wl-base/winterlab/hardware/photos/hand-soldered.JPG

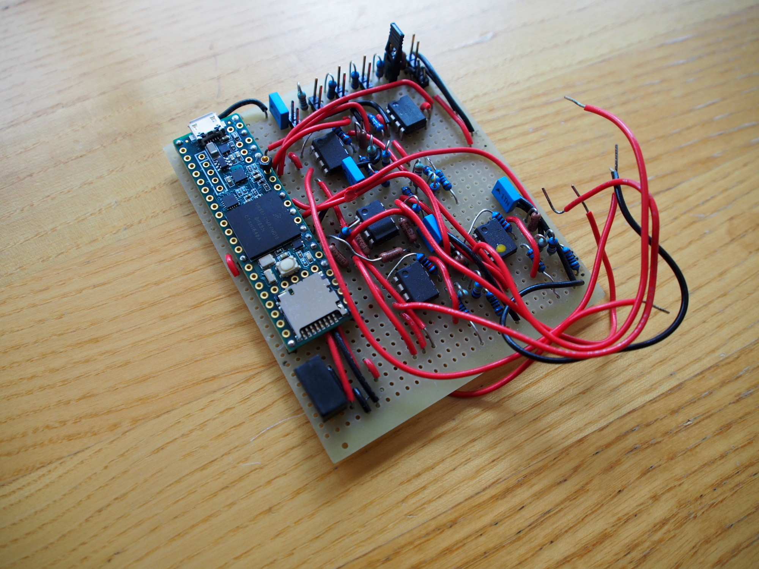
hardware/photos/hand-soldered.JPG
