wl-base/winterlab/hardware/schematics/winterlab_functional_diagram (7).png

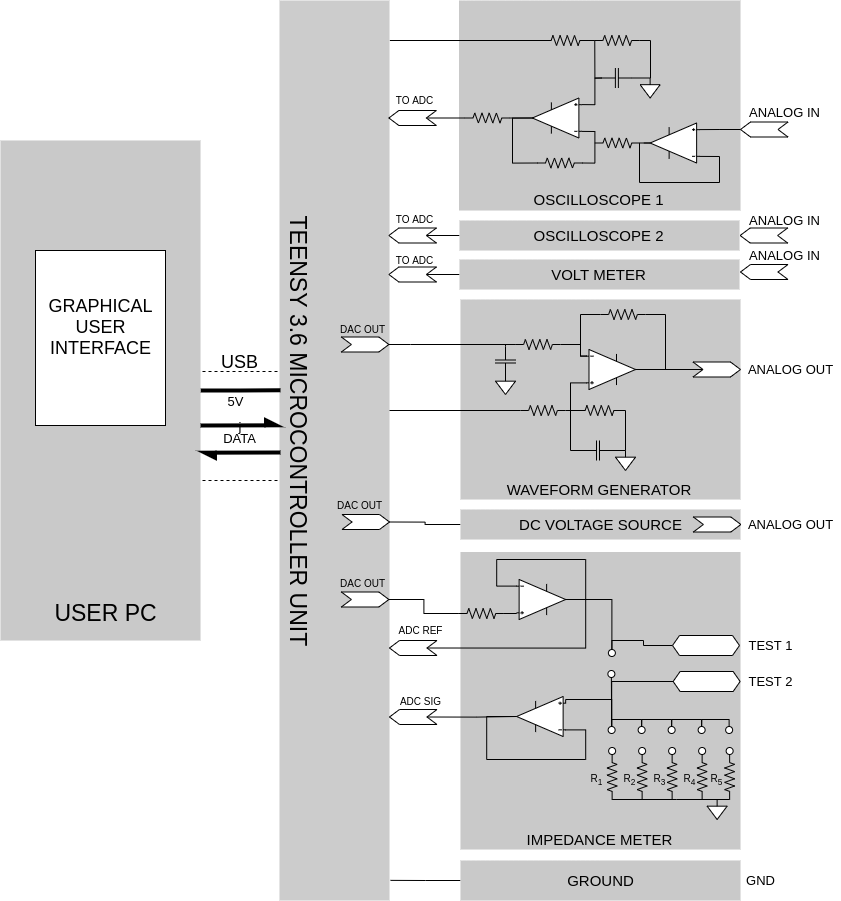
hardware/schematics/winterlab_functional_diagram (7).png
