wl-base/winterlab/hardware/photos/assembled_winterlab.pdf

### Example manufactured

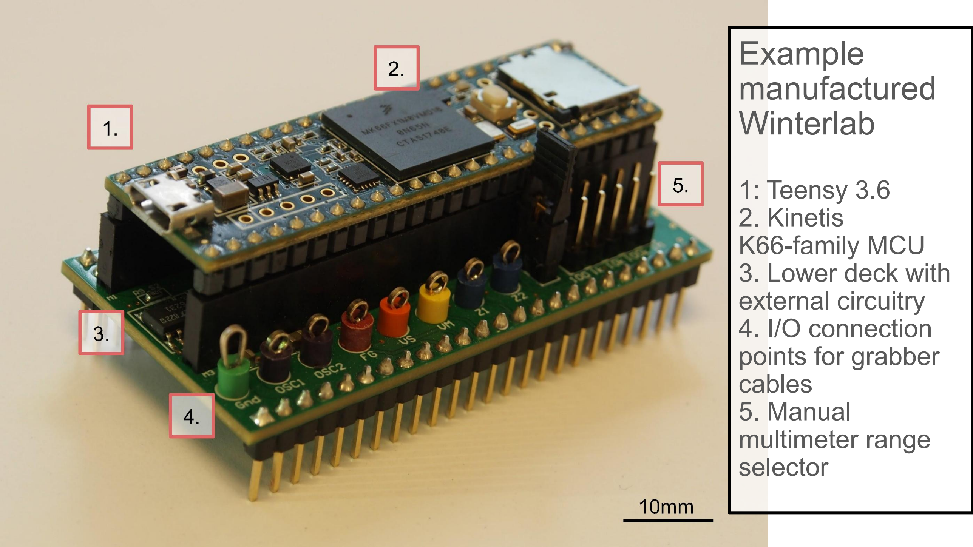
[picture p15: page 1]

### Winterlab

1: Teensy 3.6
2. Kinetis
K66-family MCU
3. Lower deck with
external circuitry
4. I/O connection
points for grabber
cables
5. Manual
multimeter range
selector
