wl-base/winterlab/hardware/schematics/WinterLab.pdf

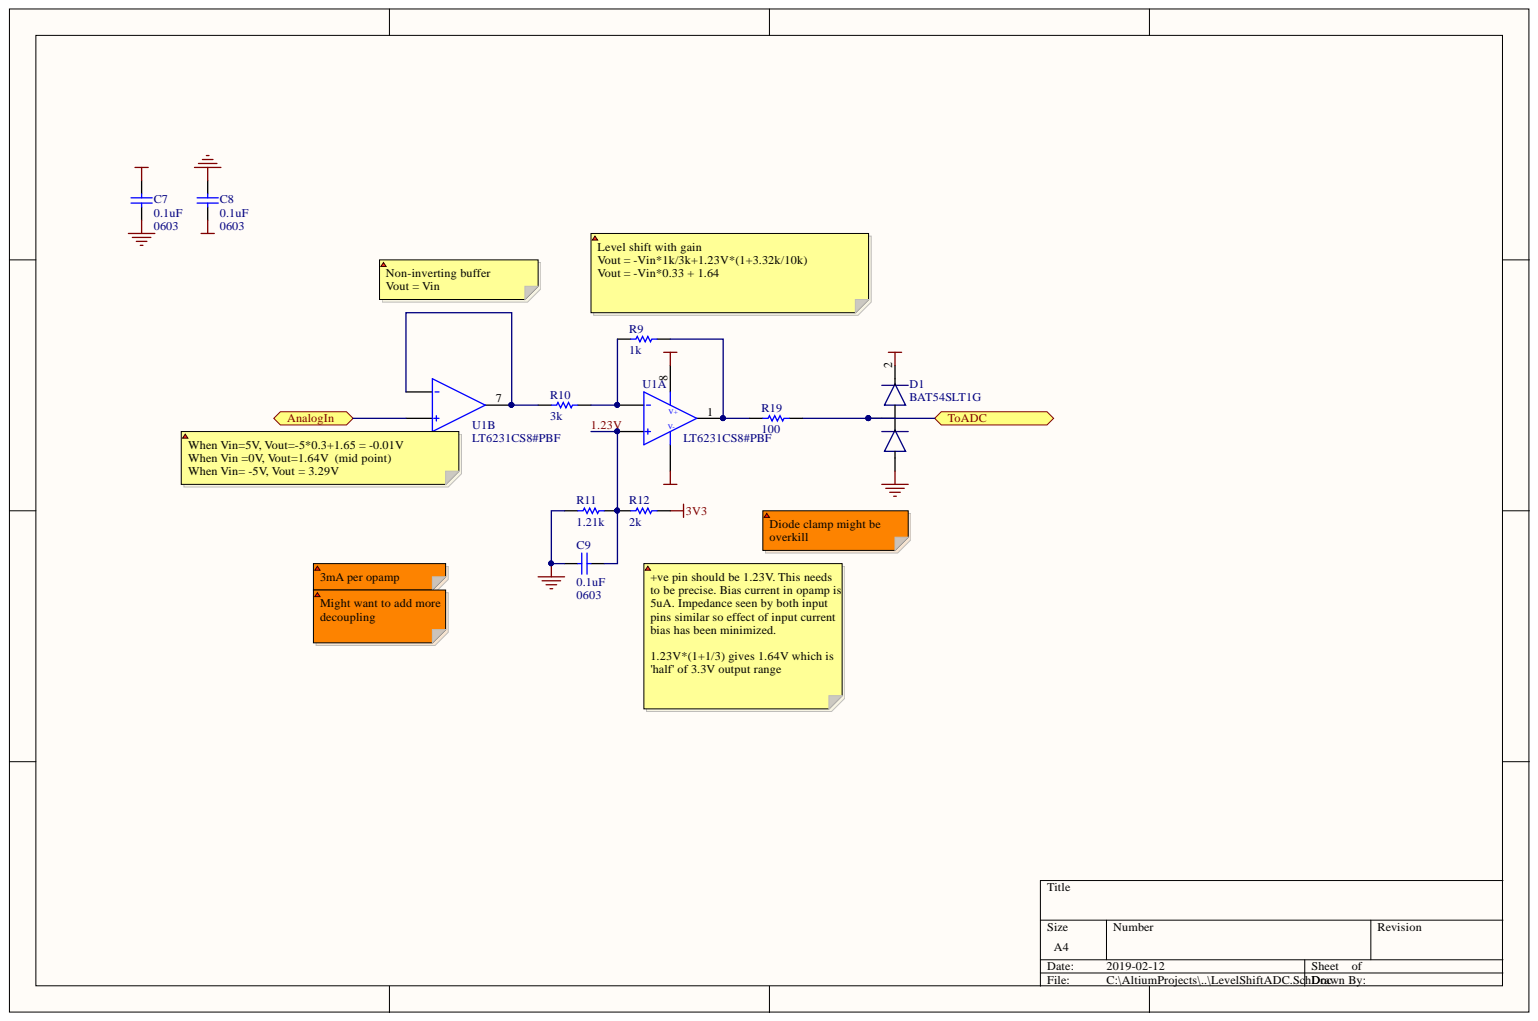
[picture p16: page 1]

Level shift with gain
Vout = -Vin*1k/3k+1.23V*(1+3.32k/10k)
Vout = -Vin*0.33 + 1.64

When Vin=5V, Vout=-5*0.3+1.65 = -0.01V
When Vin =0V, Vout=1.64V (mid point)
When Vin= -5V, Vout = 3.29V

Diode clamp might be
overkill

+ve pin should be 1.23V. This needs
to be precise. Bias current in opamp is
5uA. Impedance seen by both input
pins similar so effect of input current
bias has been minimized.

Might want to add more
decoupling

1.23V*(1+1/3) gives 1.64V which is
'half' of 3.3V output range

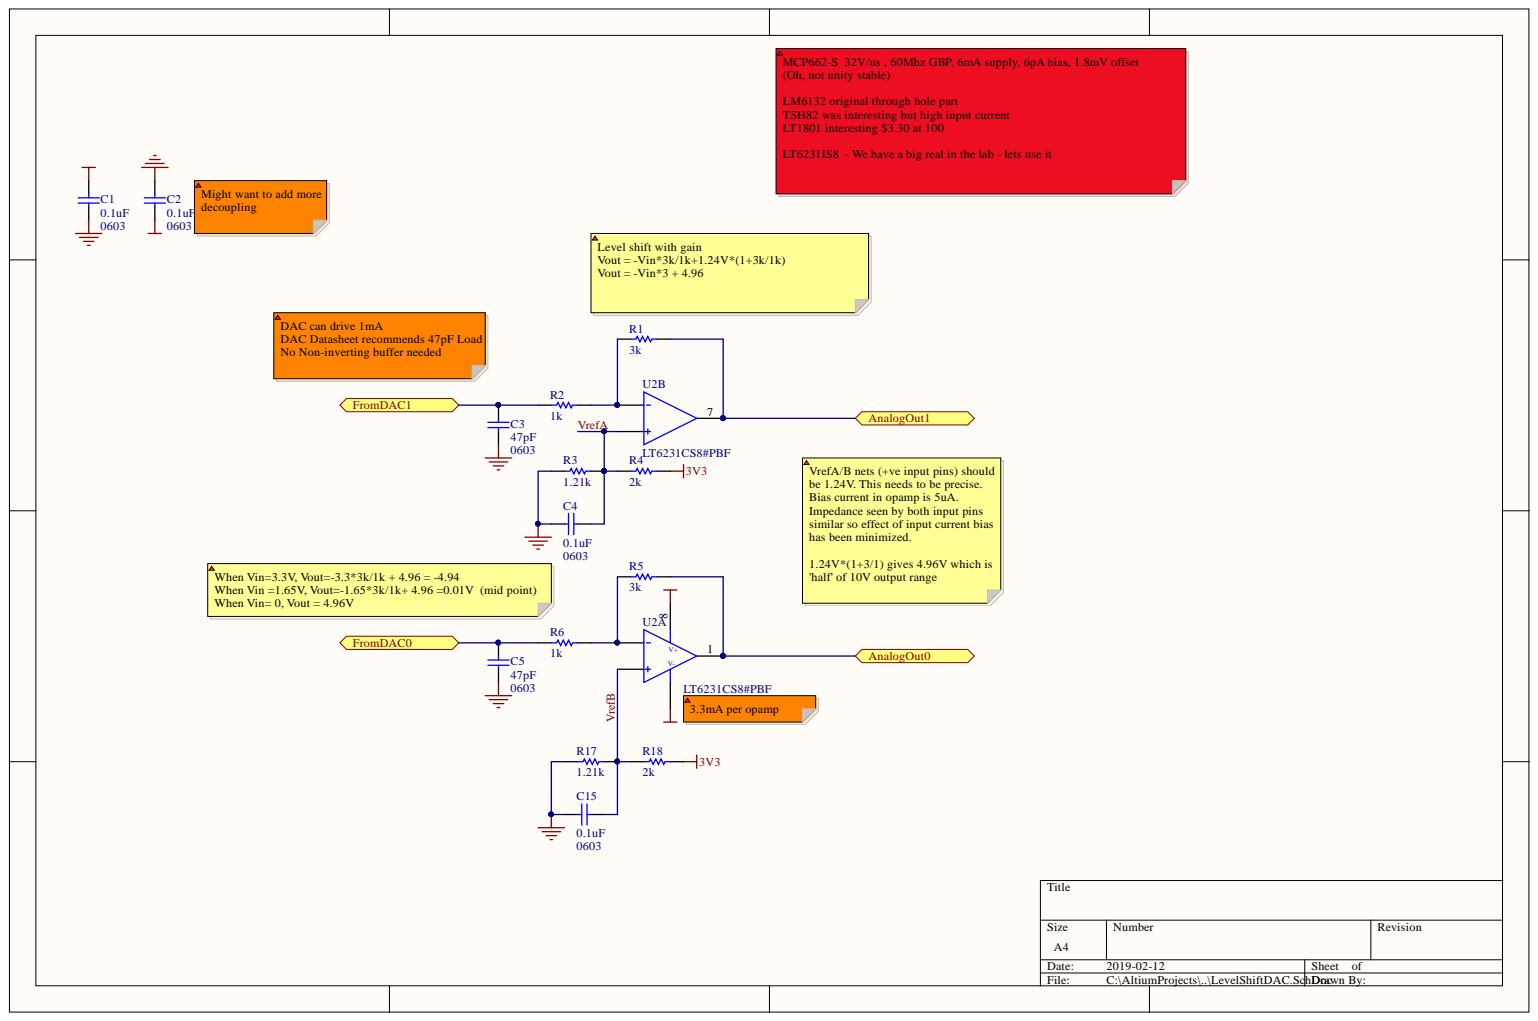
[picture p17: page 2]

MCP662-S 32V/us , 60Mhz GBP, 6mA supply, 6pA bias, 1.8mV offset
(Oh, not unity stable)

LM6132 original through hole part
TSH82 was interesting but high input current
LT1801 interesting $3.30 at 100

LT6231IS8 - We have a big real in the lab - lets use it

Might want to add more
decoupling

Level shift with gain
Vout = -Vin*3k/1k+1.24V*(1+3k/1k)
Vout = -Vin*3 + 4.96

DAC can drive 1mA
DAC Datasheet recommends 47pF Load
No Non-inverting buffer needed

VrefA/B nets (+ve input pins) should
be 1.24V. This needs to be precise.
Bias current in opamp is 5uA.
Impedance seen by both input pins
similar so effect of input current bias
has been minimized.

When Vin=3.3V, Vout=-3.3*3k/1k + 4.96 = -4.94
When Vin =1.65V, Vout=-1.65*3k/1k+ 4.96 =0.01V (mid point)
When Vin= 0, Vout = 4.96V

1.24V*(1+3/1) gives 4.96V which is
'half' of 10V output range

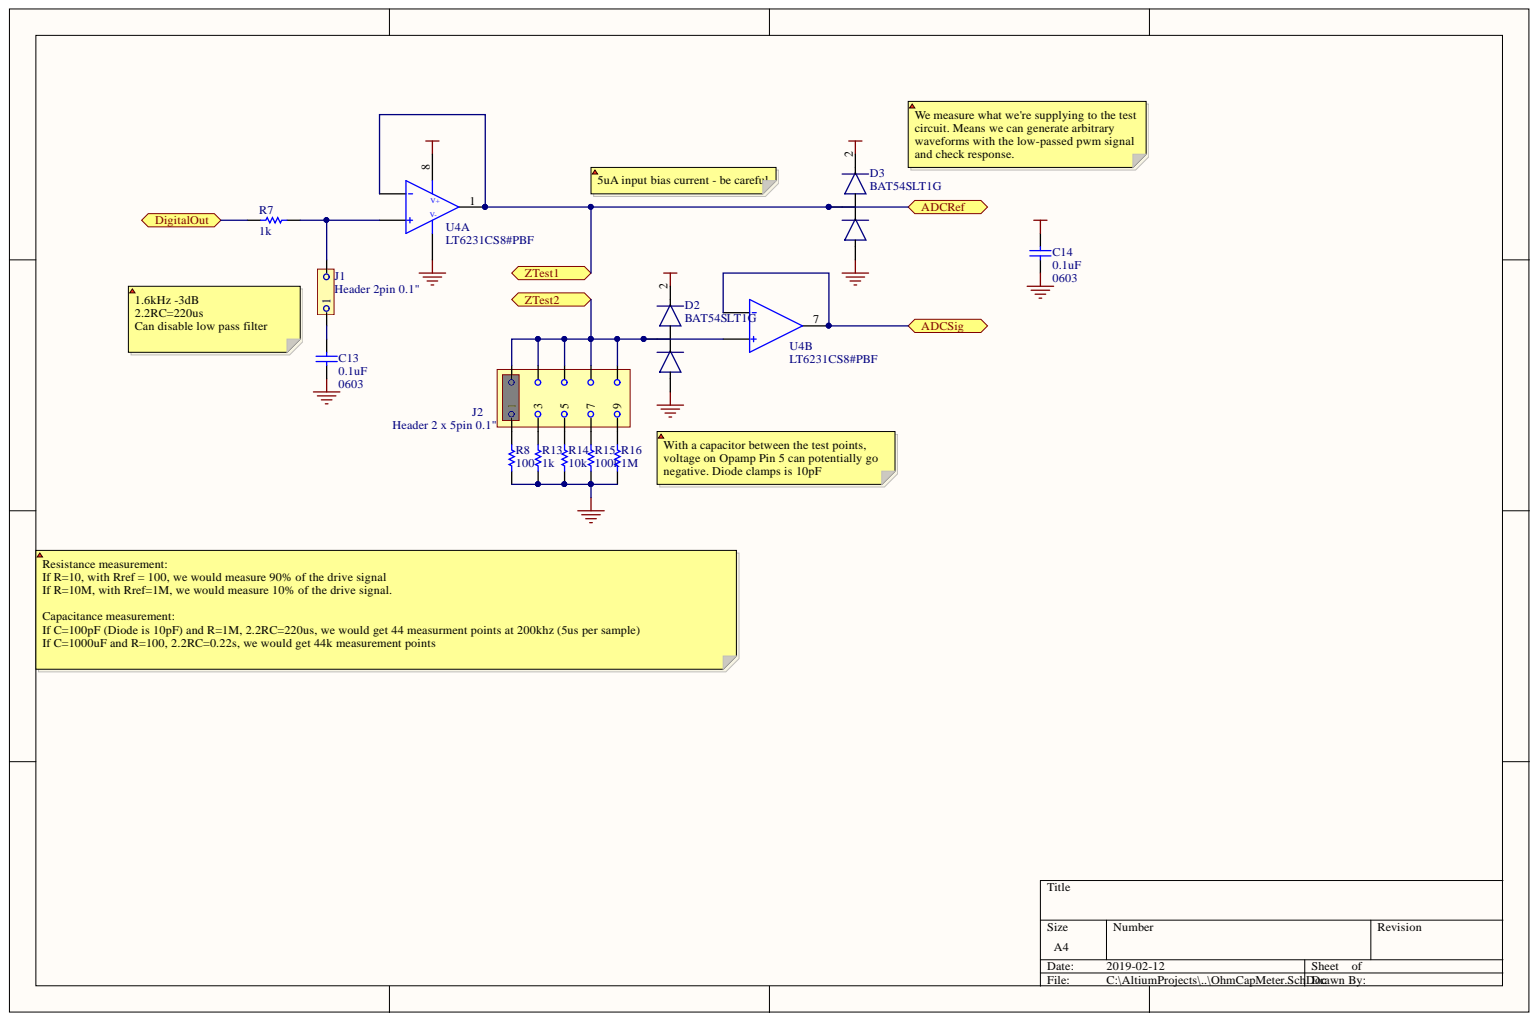
[picture p18: page 3]

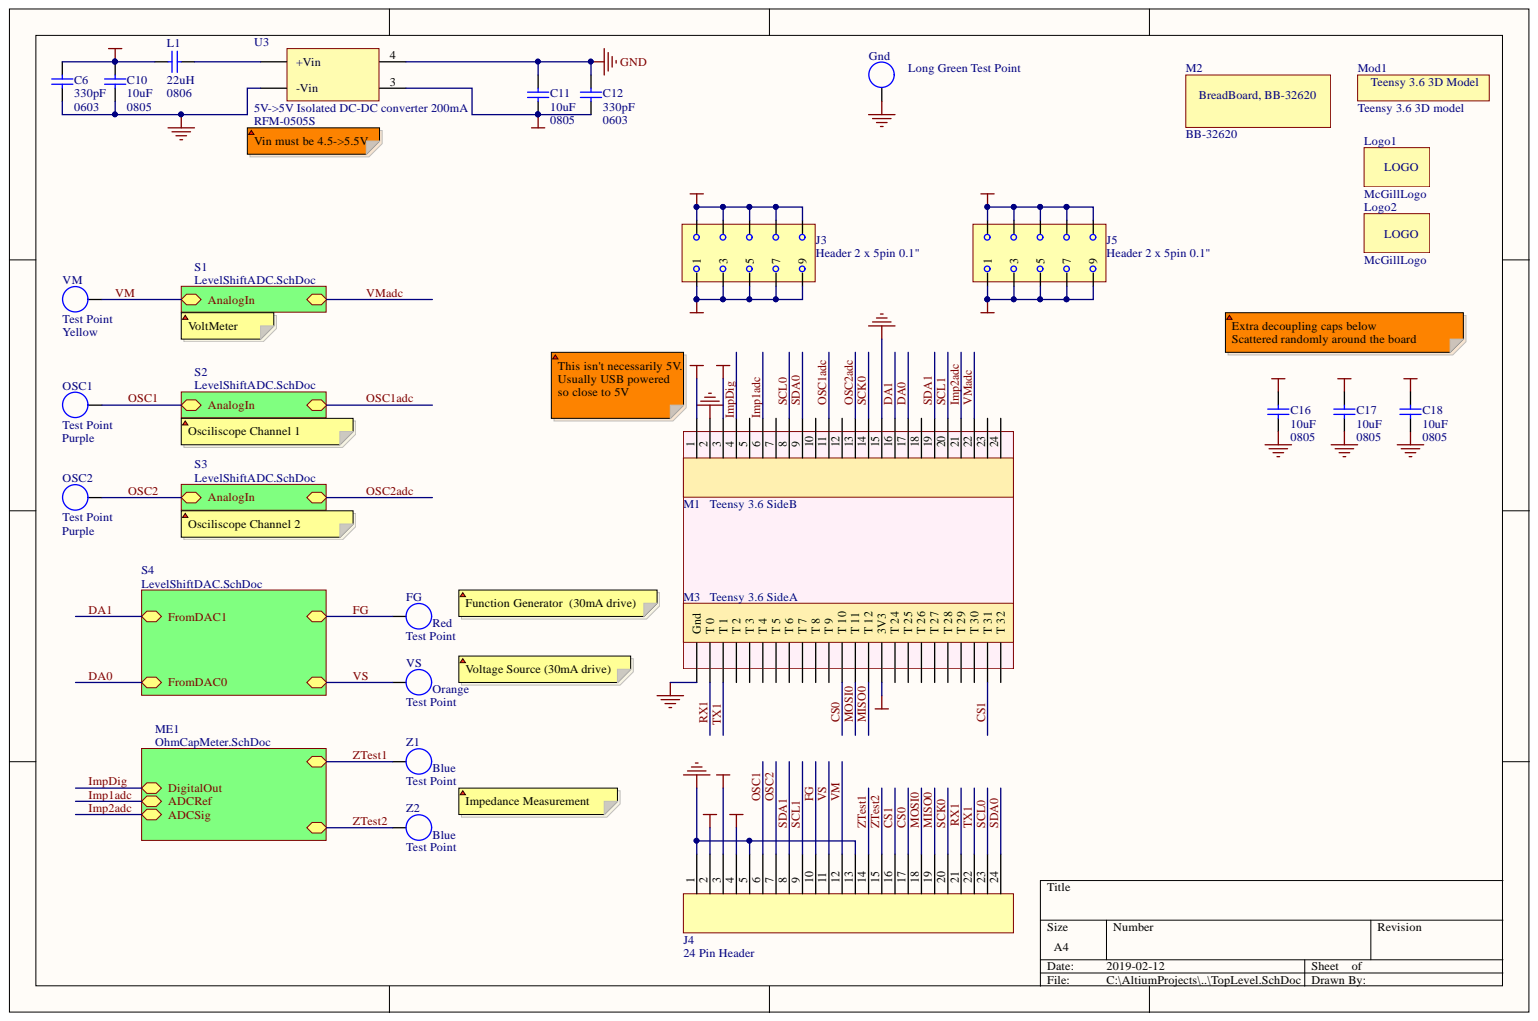
[picture p19: page 4]

Long Green Test Point

5V->5V Isolated DC-DC converter 200mA
RFM-0505S
Vin must be 4.5->5.5V

Extra decoupling caps below
Scattered randomly around the board
