wl-base/winterlab/winterlab_firmware/winterlab_firmware.ino

// Firmware for WinterLab platform, designed to be run on a Teensy 3.6
// Author: M Rouble
// Last updated: 2020


#define ARM_MATH_CM4
#include <DMAChannel.h>
#include "pdb.h"
#include <avr/pgmspace.h>
#include <ADC.h>
#include <array>
#include <arm_math.h>


// Define pinout, wavetables, global settings

DMAChannel dma0(false);
DMASetting dma1;
DMASetting dma2;

ADC *adc = new ADC();
const int readPin0 = A0;
const int readPin1 = A2;

const int meterPinOut = A9; 
const int meterPinIn = A17;
const int meterPinRef = A7;
const int voltMeterPin = A16;
const int dcpin = A21;
int rangeDMM;

char rangeBuff[2]; // 2 through 6, powers of ten


// the DAC uses a direct digital synthesis algorithm to generate waveforms
// for more info, see for example https://www.analog.com/media/en/training-seminars/tutorials/MT-085.pdf
const uint16_t sinetable[] PROGMEM = {
  2047, 2050, 2053, 2056, 2060, 2063, 2066, 2069, 2072, 2075, 2078, 2082, 2085, 2088, 2091, 2094, 2097, 2100, 2104, 2107, 2110, 2113, 2116, 2119, 2122, 2126, 2129, 2132, 2135, 2138, 2141, 2144, 2147, 2151, 2154, 2157, 2160, 2163, 2166, 2169, 2173, 2176, 2179, 2182, 2185, 2188, 2191, 2194, 2198, 2201, 2204, 2207, 2210, 2213, 2216, 2220, 2223, 2226, 2229, 2232, 2235, 2238, 2241, 2245, 2248, 2251, 2254, 2257, 2260, 2263, 2266, 2270, 2273, 2276, 2279, 2282, 2285, 2288, 2291, 2295, 2298, 2301, 2304, 2307, 2310, 2313, 2316, 2319, 2323, 2326, 2329, 2332, 2335, 2338, 2341, 2344, 2347, 2351, 2354, 2357, 2360, 2363, 2366, 2369, 2372, 2375, 2378, 2382, 2385, 2388, 2391, 2394, 2397, 2400, 2403, 2406, 2409, 2413, 2416, 2419, 2422, 2425, 2428, 2431, 2434, 2437, 2440, 2443, 2446, 2450, 2453, 2456, 2459, 2462, 2465, 2468, 2471, 2474, 2477, 2480, 2483, 2486, 2489, 2493, 2496, 2499, 2502, 2505, 2508, 2511, 2514, 2517, 2520, 2523, 2526, 2529, 2532, 2535, 2538, 2541, 2545, 2548, 2551, 2554, 2557, 2560, 2563, 2566, 2569, 2572, 2575, 2578, 2581, 2584, 2587, 2590, 2593, 2596, 2599, 2602, 2605, 2608, 2611, 2614, 2617, 2620, 2623, 2626, 2629, 2632, 2635, 2638, 2641, 2644, 2647, 2650, 2653, 2656, 2659, 2662, 2665, 2668, 2671, 2674, 2677, 2680, 2683, 2686, 2689, 2692, 2695, 2698, 2701, 2704, 2707, 2710, 2713, 2716, 2719, 2722, 2725, 2728, 2731, 2734, 2737, 2740, 2743, 2746, 2749, 2752, 2754, 2757, 2760, 2763, 2766, 2769, 2772, 2775, 2778, 2781, 2784, 2787, 2790, 2793, 2796, 2799, 2801, 2804, 2807, 2810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

const uint16_t squaretable[] PROGMEM = {
   0, 0, 0, 0, 0, 0, 0, 0, 0, 0, 0, 0, 0, 0, 0, 0, 0, 0, 0, 0, 0, 0, 0, 0, 0, 0, 0, 0, 0, 0, 0, 0, 0, 0, 0, 0, 0, 0, 0, 0, 0, 0, 0, 0, 0, 0, 0, 0, 0, 0, 0, 0, 0, 0, 0, 0, 0, 0, 0, 0, 0, 0, 0, 0, 0, 0, 0, 0, 0, 0, 0, 0, 0, 0, 0, 0, 0, 0, 0, 0, 0, 0, 0, 0, 0, 0, 0, 0, 0, 0, 0, 0, 0, 0, 0, 0, 0, 0, 0, 0, 0, 0, 0, 0, 0, 0, 0, 0, 0, 0, 0, 0, 0, 0, 0, 0, 0, 0, 0, 0, 0, 0, 0, 0, 0, 0, 0, 0, 0, 0, 0, 0, 0, 0, 0, 0, 0, 0, 0, 0, 0, 0, 0, 0, 0, 0, 0, 0, 0, 0, 0, 0, 0, 0, 0, 0, 0, 0, 0, 0, 0, 0, 0, 0, 0, 0, 0, 0, 0, 0, 0, 0, 0, 0, 0, 0, 0, 0, 0, 0, 0, 0, 0, 0, 0, 0, 0, 0, 0, 0, 0, 0, 0, 0, 0, 0, 0, 0, 0, 0, 0, 0, 0, 0, 0, 0, 0, 0, 0, 0, 0, 0, 0, 0, 0, 0, 0, 0, 0, 0, 0, 0, 0, 0, 0, 0, 0, 0, 0, 0, 0, 0, 0, 0, 0, 0, 0, 0, 0, 0, 0, 0, 0, 0, 0, 0, 0, 0, 0, 0, 0, 0, 0, 0, 0, 0, 0, 0, 0, 0, 0, 0, 0, 0, 0, 0, 0, 0, 0, 0, 0, 0, 0, 0, 0, 0, 0, 0, 0, 0, 0, 0, 0, 0, 0, 0, 0, 0, 0, 0, 0, 0, 0, 0, 0, 0, 0, 0, 0, 0, 0, 0, 0, 0, 0, 0, 0, 0, 0, 0, 0, 0, 0, 0, 0, 0, 0, 0, 0, 0, 0, 0, 0, 0, 0, 0, 0, 0, 0, 0, 0, 0, 0, 0, 0, 0, 0, 0, 0, 0, 0, 0, 0, 0, 0, 0, 0, 0, 0, 0, 0, 0, 0, 0, 0, 0, 0, 0, 0, 0, 0, 0, 0, 0, 0, 0, 0, 0, 0, 0, 0, 0, 0, 0, 0, 0, 0, 0, 0, 0, 0, 0, 0, 0, 0, 0, 0, 0, 0, 0, 0, 0, 0, 0, 0, 0, 0, 0, 0, 0, 0, 0, 0, 0, 0, 0, 0, 0, 0, 0, 0, 0, 0, 0, 0, 0, 0, 0, 0, 0, 0, 0, 0, 0, 0, 0, 0, 0, 0, 0, 0, 0, 0, 0, 0, 0, 0, 0, 0, 0, 0, 0, 0, 0, 0, 0, 0, 0, 0, 0, 0, 0, 0, 0, 0, 0, 0, 0, 0, 0, 0, 0, 0, 0, 0, 0, 0, 0, 0, 0, 0, 0, 0, 0, 0, 0, 0, 0, 0, 0, 0, 0, 0, 0, 0, 0, 0, 0, 0, 0, 0, 0, 0, 0, 0, 0, 0, 0, 0, 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
5, 4095, 4095, 4095, 4095, 4095, 4095, 4095, 4095, 4095, 4095, 4095, 4095, 4095, 4095, 4095, 4095, 4095, 4095, 4095, 4095, 4095, 4095, 4095, 4095, 4095, 4095, 4095, 4095, 4095, 4095, 4095, 4095, 4095, 4095, 4095, 4095, 4095, 4095, 4095, 4095, 4095, 4095, 4095, 4095, 4095, 4095, 4095, 4095, 4095, 4095, 4095, 4095, 4095, 4095, 4095, 4095, 4095, 4095, 4095, 4095, 4095, 4095, 4095, 4095, 4095, 4095, 4095, 4095, 4095, 4095, 4095, 4095};

const uint16_t lintable[] PROGMEM = { 
   0, 1, 2, 3, 4, 5, 6, 7, 8, 9, 10, 11, 12, 13, 14, 15, 16, 17, 18, 19, 20, 21, 22, 23, 24, 25, 26, 27, 28, 29, 30, 31, 32, 33, 34, 35, 36, 37, 38, 39, 40, 41, 42, 43, 44, 45, 46, 47, 48, 49, 50, 51, 52, 53, 54, 55, 56, 57, 58, 59, 60, 61, 62, 63, 64, 65, 66, 67, 68, 69, 70, 71, 72, 73, 74, 75, 76, 77, 78, 79, 80, 81, 82, 83, 84, 85, 86, 87, 88, 89, 90, 91, 92, 93, 94, 95, 96, 97, 98, 99, 100, 101, 102, 103, 104, 105, 106, 107, 108, 109, 110, 111, 112, 113, 114, 115, 116, 117, 118, 119, 120, 121, 122, 123, 124, 125, 126, 127, 128, 129, 130, 131, 132, 133, 134, 135, 136, 137, 138, 139, 140, 141, 142, 143, 144, 145, 146, 147, 148, 149, 150, 151, 152, 153, 154, 155, 156, 157, 158, 159, 160, 161, 162, 163, 164, 165, 166, 167, 168, 169, 170, 171, 172, 173, 174, 175, 176, 177, 178, 179, 180, 181, 182, 183, 184, 185, 186, 187, 188, 189, 190, 191, 192, 193, 194, 195, 196, 197, 198, 199, 200, 201, 202, 203, 204, 205, 206, 207, 208, 209, 210, 211, 212, 213, 214, 215, 216, 217, 218, 219, 220, 221, 222, 223, 224, 225, 226, 227, 228, 229, 230, 231, 232, 233, 234, 235, 236, 237, 238, 239, 240, 241, 242, 243, 244, 245, 246, 247, 248, 249, 250, 251, 252, 253, 254, 255, 256, 257, 258, 259, 260, 261, 262, 263, 264, 265, 266, 267, 268, 269, 270, 271, 272, 273, 274, 275, 276, 277, 278, 279, 280, 281, 282, 283, 284, 285, 286, 287, 288, 289, 290, 291, 292, 293, 294, 295, 296, 297, 298, 299, 300, 301, 302, 303, 304, 305, 306, 307, 308, 309, 310, 311, 312, 313, 314, 315, 316, 317, 318, 319, 320, 32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

const uint16_t tritable[] PROGMEM = {   
    0, 1, 3, 5, 7, 9, 11, 13, 15, 17, 19, 21, 23, 25, 27, 29, 31, 33, 35, 37, 39, 41, 43, 45, 47, 49, 51, 53, 55, 57, 59, 61, 63, 65, 67, 69, 71, 73, 75, 77, 79, 81, 83, 85, 87, 89, 91, 93, 95, 97, 99, 101, 103, 105, 107, 109, 111, 113, 115, 117, 119, 121, 123, 125, 127, 129, 131, 133, 135, 137, 139, 141, 143, 145, 147, 149, 151, 153, 155, 157, 159, 161, 163, 165, 167, 169, 171, 173, 175, 177, 179, 181, 183, 185, 187, 189, 191, 193, 195, 197, 199, 201, 203, 205, 207, 209, 211, 213, 215, 217, 219, 221, 223, 225, 227, 229, 231, 233, 235, 237, 239, 241, 243, 245, 247, 249, 251, 253, 255, 257, 259, 261, 263, 265, 267, 269, 271, 273, 275, 277, 279, 281, 283, 285, 287, 289, 291, 293, 295, 297, 299, 301, 303, 305, 307, 309, 311, 313, 315, 317, 319, 321, 323, 325, 327, 329, 331, 333, 335, 337, 339, 341, 343, 345, 347, 349, 351, 353, 355, 357, 359, 361, 363, 365, 367, 369, 371, 373, 375, 377, 379, 381, 383, 385, 387, 389, 391, 393, 395, 397, 399, 401, 403, 405, 407, 409, 411, 413, 415, 417, 419, 421, 423, 425, 427, 429, 431, 433, 435, 437, 439, 441, 443, 445, 447, 449, 451, 453, 455, 457, 459, 461, 463, 465, 467, 469, 471, 473, 475, 477, 479, 481, 483, 485, 487, 489, 491, 493, 495, 497, 499, 501, 503, 505, 507, 509, 511, 513, 515, 517, 519, 521, 523, 525, 527, 529, 531, 533, 535, 537, 539, 541, 543, 545, 547, 549, 551, 553, 555, 557, 559, 561, 563, 565, 567, 569, 571, 573, 575, 577, 579, 581, 583, 585, 587, 589, 591, 593, 595, 597, 599, 601, 603, 605, 607, 609, 611, 613, 615, 617, 619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
uint16_t alttable[bufferlen];

int wave;
float freq;
float amp;
float M;
int m_extend;
unsigned long m;
unsigned long pac;
unsigned long pac_comp;

char startword;

int trig;
int trigchannel;
char trigbuff[5];
char chbuff[2];

int dcoffset;
char offsetbuff[6];
int ypos;

char voltbuff[4]; //stores the voltage generator voltage
int volts;
int buffvolts; //used to check if incoming voltage is within range

char freqbuff[7]; //to change the frequency
char ampbuff[6];

int metered; //for the volt meter
byte bmetered;
int ometered;

const unsigned int numValues = 1024; // ADC batch length
int counter;

byte readValues0[numValues];
byte readValues1[numValues];

byte readValues[2][numValues];

int ledpin = 13;

bool prep_flag;
bool flag1;
int place;
bool upflag;


// Interrupt service routine (ISR) used to flag that the DMA buffer is ready
void dma_isr() {
  flag1 = !flag1;
  digitalWrite(ledpin, !digitalRead(ledpin));
  prep_flag = true;
  dma0.clearInterrupt();
}



void setup()
  // Purpose: Establishes pin settings and starting values.
  //          Does some black magic to initialize the DACs and ADCs to run at high speed.
  // Date added: Aug. 2017
  // Data modified: Jan 2019
  
{
  Serial.begin(115200);

  analogWriteResolution(8);
  analogReadResolution(8);
  analogReadAveraging(8);
  
  pinMode(readPin0, INPUT);
  pinMode(readPin1, INPUT);
  pinMode(meterPinOut, OUTPUT);
  pinMode(meterPinRef, INPUT);
  pinMode(meterPinIn, INPUT);
  pinMode(ledpin, OUTPUT);
  pinMode(dcpin, OUTPUT);
  pinMode(A22, OUTPUT); // what is A22

  freq = 1000.0; //default values

  trig = 127;
  trigchannel = 1;

  for(int i = 0; i<bufferlen; i++) { //clear the output table
    table1[i] = 0;
    table2[i] = 0;
  }

  amp = 0.2;
  ypos = 0;
  dcoffset = 2048;
  m_extend = 8; // bit boost for phase acc.
  M = ((float)freq * (float)pow(2,table_res)) / (float)f_clk;
  m = M*pow(2, m_extend);
  pac = 0;
  pac_comp = pow(2, 24);
  wave = 6; //blank
 
  counter = 0;

  metered = 0; 
  bmetered = 0;

  rangeDMM = 100;

  adc->setAveraging(1);
  adc->setResolution(8);
  adc->setConversionSpeed(ADC_CONVERSION_SPEED::VERY_HIGH_SPEED);
  adc->setSamplingSpeed(ADC_SAMPLING_SPEED::VERY_HIGH_SPEED);

  adc->setAveraging(1, ADC_1);
  adc->setResolution(8, ADC_1);
  adc->setConversionSpeed(ADC_CONVERSION_SPEED::VERY_HIGH_SPEED, ADC_1);
  adc->setSamplingSpeed(ADC_SAMPLING_SPEED::VERY_HIGH_SPEED, ADC_1);

  adc->startSynchronizedContinuous(readPin0, readPin1);
  delay(500);

  // Configure PDB block for DMA timing
  SIM_SCGC2 |= SIM_SCGC2_DAC1; // enable DAC clock
  DAC1_C0 = DAC_C0_DACEN | DAC_C0_DACRFS; // enable the DAC module, 3.3V reference
  // slowly ramp up to DC voltage, approx 1/4 second
  for (int16_t i=0; i<2048; i+=8) {
    *(int16_t *)&(DAC1_DAT0L) = i;
    delay(1);
  }

  // set the programmable delay block to trigger DMA requests
  SIM_SCGC6 |= SIM_SCGC6_PDB; // enable PDB clock
  PDB0_IDLY = 0; // interrupt delay register
  //PDB0_MOD = PDB_PERIOD; // modulus register, sets period
  PDB0_MOD = 14;
  PDB0_SC = PDB_CONFIG | PDB_SC_LDOK; // load registers from buffers
  PDB0_SC = PDB_CONFIG | PDB_SC_SWTRIG; // reset and restart
  PDB0_CH0C1 = 0x0101; // channel n control register?

  dma0.begin(true);
  dma0.triggerAtHardwareEvent(DMAMUX_SOURCE_PDB);
  
  dma1.sourceBuffer(table1, sizeof(table1));
  dma1.destination(*(volatile uint16_t *)&(DAC1_DAT0L));
  dma1.interruptAtCompletion();
  dma1.replaceSettingsOnCompletion(dma2);

  dma2.sourceBuffer(table2, sizeof(table2));
  dma2.destination(*(volatile uint16_t *)&(DAC1_DAT0L));
  dma2.interruptAtCompletion();
  dma2.replaceSettingsOnCompletion(dma1);

  dma0 = dma1;
  dma0.enable();
  dma0.attachInterrupt(dma_isr);
  
  
  // set up the starting output values --> DC supply, function generator
  analogWrite(dcpin, 128);
  wave = 6;
  prep_flag = false;
  flag1 = false;
  place = 0;
  
}

int value0 = 0;
int value1 = 0;

ADC::Sync_result result;



void readFromSerial() {
  // Purpose: parses input from python GUI and directs board to take assigned action.
  // Date added: Aug. 2017
  // Data modified: Jan 2019
  
  startword = Serial.read();
  if (startword == 'F') {
    getFreq();
  }
  if (startword == 'A') {
    getAmp();
  }
  if (startword == 'S') {
    wave = 1; //sine
    Serial.println('0');
  }
  if (startword == 'R') {
    wave = 2; //tri
    Serial.println('0');
  }
  if (startword == 'U') {
    wave = 3; //saw
    Serial.println('0');
  }
  if (startword == 'Q') {
    wave = 4; //square
    Serial.println('0');
  }
  if (startword == 'W') {
    wave = 5; //noise
    Serial.println('0');
  }
  if (startword == 'B') {
    wave = 6; //off
    Serial.println('0');
  }
  if (startword == 'M') {
    getVoltMeter();
  }
  if (startword == 'O') {
    getOhmMeter();
  }
  if(startword == 'I') {
    getCapMeter();
  }
  if (startword == 'H') {
    getDMMRange();
  }
  if (startword == 'T') {
    getTrigger();
  }
  if (startword == 'C') {
    getTriggerChannel();
  }
  if (startword == 'D') {
    getOffset();
  }
  if (startword == 'Z') {
    twoChannelOsc();
  }
  if(startword == 'E') {
    measureRange(0);
  }
  if(startword == 'G') {
    measureRange(1);
  }
  if(startword == 'J') {
    getDC();
  }
  
  else {
    while (Serial.available()) {
      char t = Serial.read();
    }
  }
}

void getVoltMeter() { 
  // Purpose: Reads a voltage at the voltMeterPin and reports it
  // Date added: Aug. 2017
  // Data modified: Nov 2018
  
  float metered = 0;
  int sum = 0;
  for(int i=0; i<100; i++) {
    sum = sum + analogRead(voltMeterPin);
  }
  metered = (float)sum/100.0;
  Serial.flush();
  Serial.print(metered);
  Serial.println("");
  delay(10);
 
}

void getDMMRange() { 
  // Purpose: reads the current multimeter range from Python (2: 100ohm, 3: 1k, 4: 10k, 5: 100k, 6: 1M)
  // Date added: Oct. 2018
  // Data modified: Oct. 2018
  Serial.readBytesUntil('\n', rangeBuff, 2);
  rangeBuff[1] = '\0';
  int mult = atoi(rangeBuff);
  rangeDMM = pow(10, mult);
  Serial.println('0');
}


void getOhmMeter() {
  // Purpose: uses a voltage divider to measure the value of an unknown resistance.
  // Date added: Aug. 2017
  // Data modified: Jan 2019
  digitalWrite(meterPinOut, HIGH);
  int vreftot = 0;
  int vmtot = 0;
  int R2;
  for(int i = 0; i < 100; i ++) {
    vreftot = vreftot + analogRead(meterPinRef);
    vmtot = vmtot + analogRead(meterPinIn);    
  }
  digitalWrite(meterPinOut, LOW);
  float vrefavg = (float)vreftot/100.0;
  float vmavg = (float)vmtot/100.0;

  if(vmavg <= vrefavg*0.1 ){  
      R2 = -1; // Range error; range too small
    }
  else  if(vmavg >= vrefavg*0.9) {
      R2 = -2; // Range error: range too large
    } 
  else {
    R2 = rangeDMM*(vrefavg/vmavg - 1);
  }
  Serial.flush();
  Serial.println(R2);
}
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
void loop() { //the actual execution loop
  if(Serial.available()>0) { //if we're getting a command from python
    readFromSerial();
  }
  if(prep_flag) {
    prep();
  }

}
