wl-base/winterlab/winterlab_firmware/pdb.h

/* Audio Library for Teensy 3.X
 * Copyright (c) 2014, Paul Stoffregen, paul@pjrc.com
 * Modified 2015, Ferdinand Keil, ferdinandkeil@gmail.com
 *
 * Development of this audio library was funded by PJRC.COM, LLC by sales of
 * Teensy and Audio Adaptor boards.  Please support PJRC's efforts to develop
 * open source software by purchasing Teensy or other PJRC products.
 *
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
 * THE SOFTWARE IS PROVIDED "AS IS", WITHOUT WARRANTY OF ANY KIND, EXPRESS OR
 * IMPLIED, INCLUDING BUT NOT LIMITED TO THE WARRANTIES OF MERCHANTABILITY,
 * FITNESS FOR A PARTICULAR PURPOSE AND NONINFRINGEMENT. IN NO EVENT SHALL THE
 * AUTHORS OR COPYRIGHT HOLDERS BE LIABLE FOR ANY CLAIM, DAMAGES OR OTHER
 * LIABILITY, WHETHER IN AN ACTION OF CONTRACT, TORT OR OTHERWISE, ARISING FROM,
 * OUT OF OR IN CONNECTION WITH THE SOFTWARE OR THE USE OR OTHER DEALINGS IN
 * THE SOFTWARE.
 */

#ifndef pdb_h_
#define pdb_h_

#include "kinetis.h"

// Multiple input & output objects use the Programmable Delay Block
// to set their sample rate.  They must all configure the same
// period to avoid chaos.

#define PDB_CONFIG (PDB_SC_TRGSEL(15) | PDB_SC_PDBEN | PDB_SC_CONT | PDB_SC_PDBIE | PDB_SC_DMAEN)

#if F_BUS == 60000000
  #define PDB_PERIOD (468-1)
#elif F_BUS == 56000000
  #define PDB_PERIOD (437-1)
#elif F_BUS == 48000000 //Teensy 3.2
  #define PDB_PERIOD (60-1)
#elif F_BUS == 36000000
  #define PDB_PERIOD (281-1)
#elif F_BUS == 24000000
  #define PDB_PERIOD (187-1)
#elif F_BUS == 16000000
  #define PDB_PERIOD (125-1)
#else
  #error "Unsupported F_BUS speed"
#endif

#endif
