wl-base/winterlab/(commit log)

2020-09-28 Added hardware schematic files under ~/hardware
2020-10-08 photo of hand-assembled board and updated README
2021-01-08 additional photo of assembled board
2021-01-09 added functional diagram
    Overview of external board circuitry
